ymguo-phy/Lab_IV_Spectrometer/Lecture_Note/Spectrometer casing.png

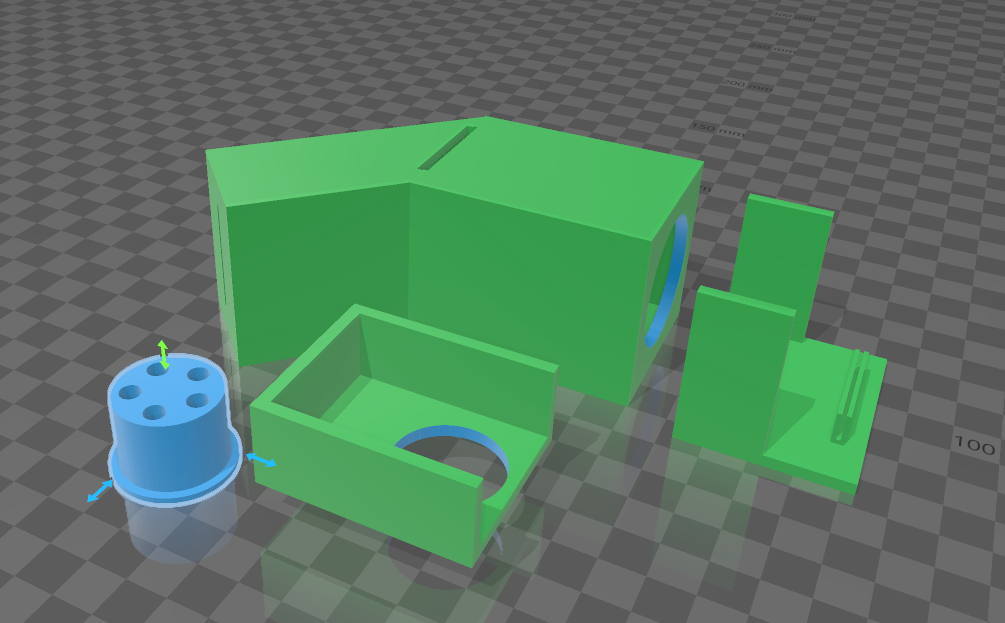
Lecture_Note/Spectrometer casing.png
