ymguo-phy/Lab_IV_Spectrometer/origin_data/Exp6/1/0_11Exp_1.jpg

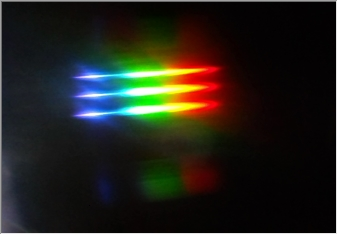
origin_data/Exp6/1/0_11Exp_1.jpg
