ymguo-phy/Lab_IV_Spectrometer/README.md

# Lab_IV_Spectrometer
This repo is built for storage the project of DIY Spectrometer.
