ymguo-phy/Lab_IV_Spectrometer/Proposal/procedure_of_LED.md

1. 校准电压表
2. 用红色激光和绿色激光校准spectrometer
3. 将指定的若干相同颜色的LED灯珠串联安装在面包板上，将面包板固定在testing module上。通过导线接通电源，确保电路连接没有问题，LED正常亮起
4. 将module连接spectrometer，接通电源，待软件显示产生稳定的光强度光谱之后，记录实验光谱。
5. 同时记录LED灯串两端的电压并记录。
6. 关闭电源，重新打开，进行重复实验，重复以上操作，记录大于3组的数据以减少误差。
7. 更换LED灯珠，使用不同颜色的LED灯，重复以上操作。
