ymguo-phy/Lab_IV_Spectrometer/Proposal/some_chart.xlsx

Sheet: Sheet1
Wavelength/ | 500nm | 650nm
Intensity
Concentration
Deionized water
0.1mol/L Solution
0.5 mol/L Solution
1 mol/L Solution
2 mol/L Solution

Sheet: Sheet2
Experiment data of Planck Constant measurement for LED light source with zero point method
Forward Voltage(V) | 0.988 | 0.691 | 0.445 | 0.382 | 0.311
Central wavelength(nm) | 629.6 | 604.1 | 593.1 | 523.4 | 462.7
Approximated wavelength(nm) | 629.6 | 608.1 | 590.1 | 529.4 | 470.8

Sheet: Sheet3
Wavelength(nm) | Grating | 5 | 10 | 15
532 | CD
 | DVD
650 | CD
 | DVD
 | Spots too close
 | Spots out of range
 | Able to conduct the experiment

Sheet: Sheet4
Camparative data of planck constant measurement experiment for LED source with zero point method
Approximated wavelength(nm) | 470.8 | 529.4 | 590.1 | 608.1 | 629.6 | the value of h | relative error(%)
1 | 1.004 | 0.72 | 0.5 | 0.448 | 0.37 | 6.0947 | 5.6
2 | 0.921 | 0.647 | 0.409 | 0.341 | 0.28 | 6.4376 | 2.9
3 | 0.943 | 0.686 | 0.466 | 0.427 | 0.299 | 6.1556 | 7.1
4 | 0.891 | 0.659 | 0.389 | 0.357 | 0.297 | 6.0723 | 8.2
