ymguo-phy/Lab_IV_Spectrometer/Proposal/exp2.md

在实验中我们使用了5种不同颜色LED灯进行试验，我们使用12V的电压提供电压，并使用不同的电阻对实验中的电流大小进行调整，以使得LED灯能够处于刚好被激发的正向电压状态，在实验中，我们将万能表调节至直流电20V的状态之下，同时将两个表笔固定的插在面包半中，用于测量并联的电压的大小
