ymguo-phy/Lab_IV_Spectrometer/Plan/20.4.2022.md

## Planck Constant

1. Design the circuit diagram

2. Essential equation

## Absorption

1. Determine the concentration resolution
2. Design model
3. Set the hypothesis and the method of experiement
4. 

## Presentation

1. Experiment Goal
2. Experiment Hypothesis
3. Distribution of Work
4. Experiment Method
5. Graph of Essential Parts
6. 实验的具体参数
7. Data analysis method
8. Some milestone progress
9. Budget

## Measure the diffraction Grating Constant (Plan)

(GUO YIMING)

1. Design the model of experiment
2. Improve the method
3.
