ymguo-phy/Lab_IV_Spectrometer/Final Report/2.jpg

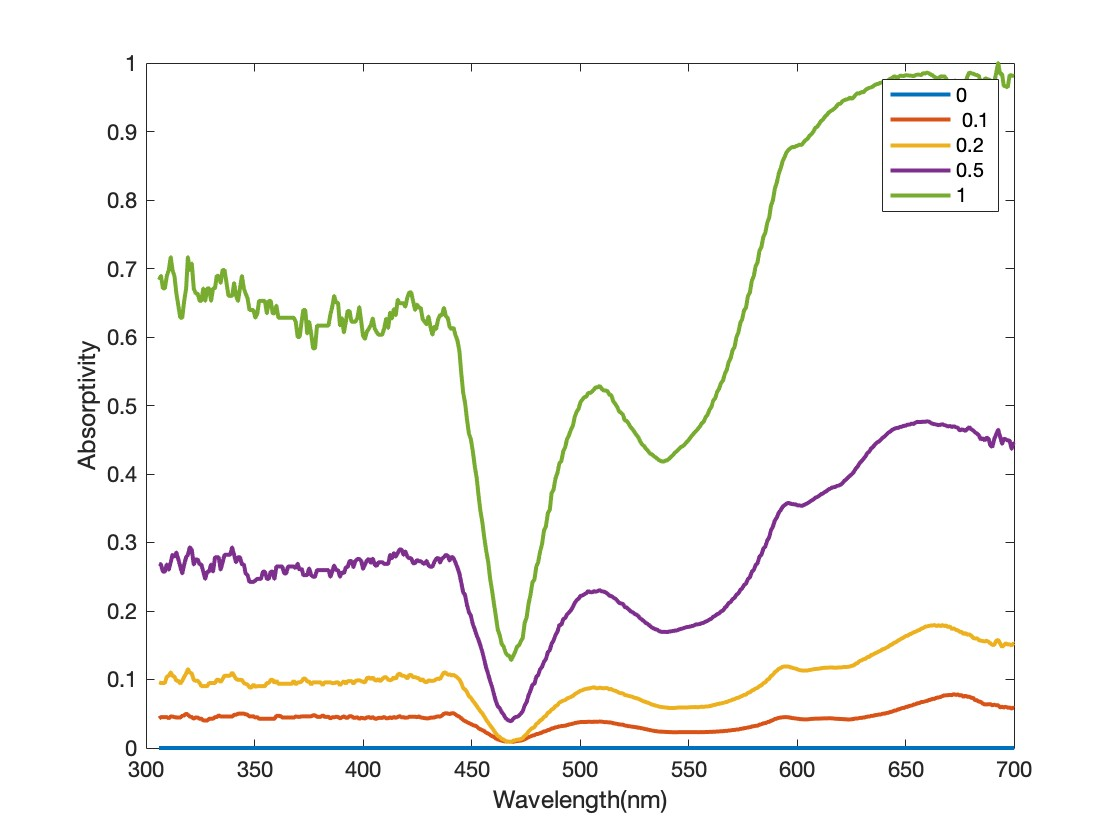
Final Report/2.jpg
