ymguo-phy/Lab_IV_Spectrometer/Final Report/modify.jpg

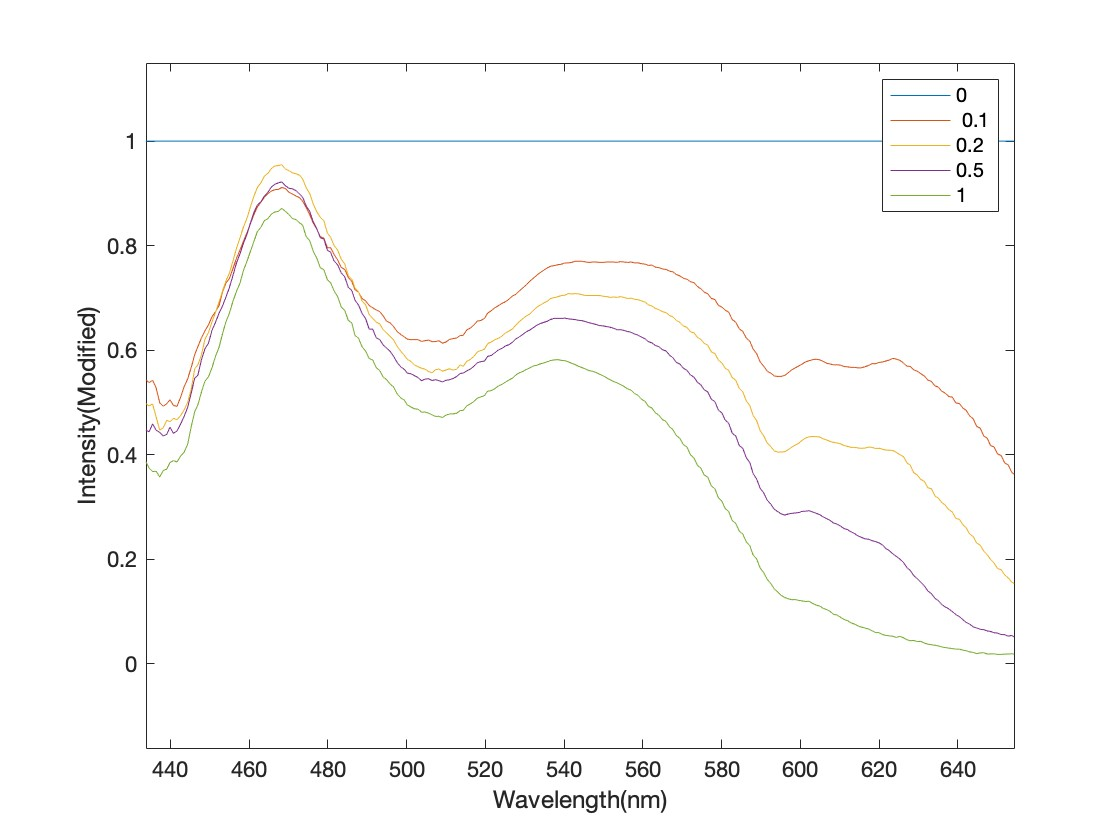
Final Report/modify.jpg
