ymguo-phy/Lab_IV_Spectrometer/Final Report/Origin_data.jpg

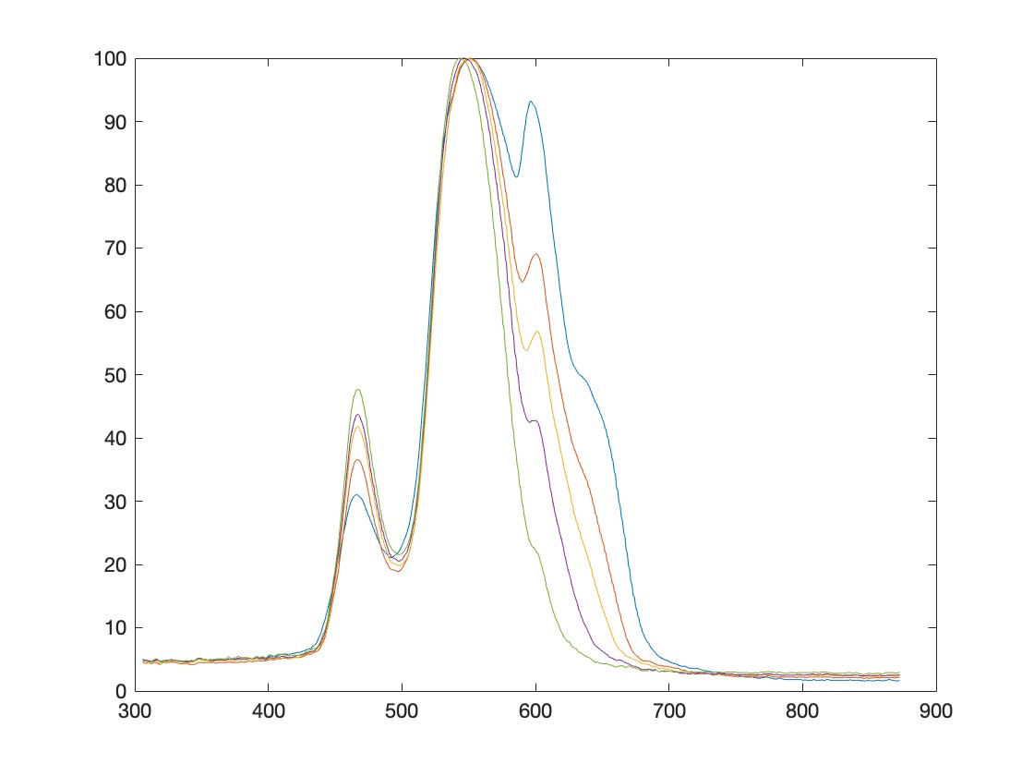
Final Report/Origin_data.jpg
