ymguo-phy/Lab_IV_Spectrometer/origin_data/Exp6/1_1/0_24.jpg

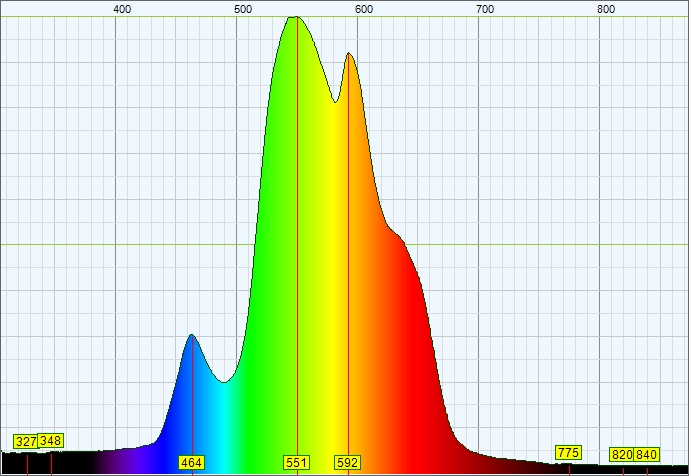
origin_data/Exp6/1_1/0_24.jpg
