ymguo-phy/Lab_IV_Spectrometer/origin_data/Exp6/1_1/0_26.jpg

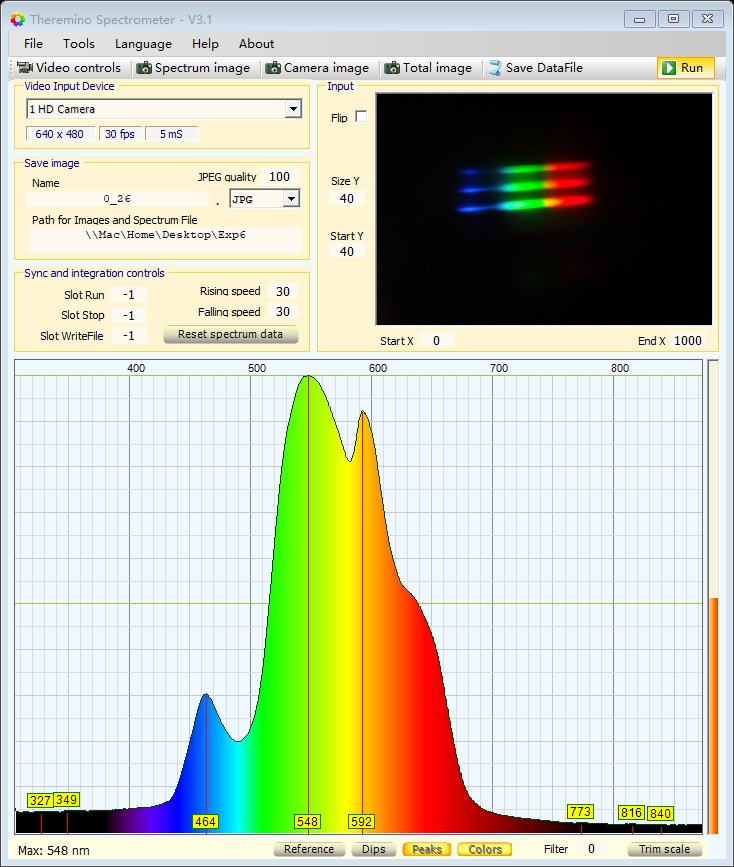
origin_data/Exp6/1_1/0_26.jpg
