ymguo-phy/Lab_IV_Spectrometer/origin_data/Exp6/2/0_12Exp_2.jpg

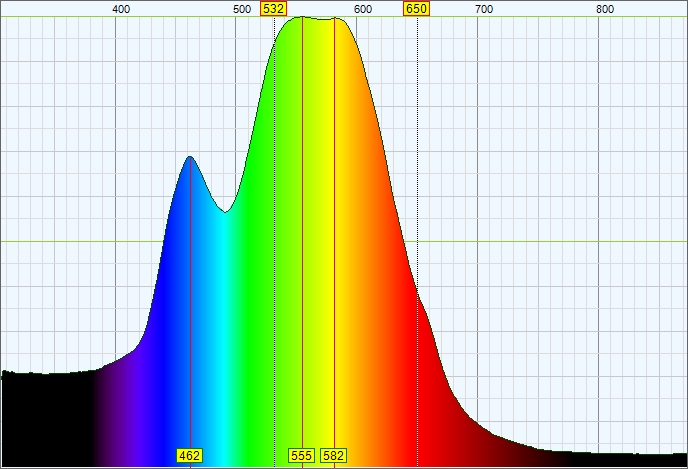
origin_data/Exp6/2/0_12Exp_2.jpg
