ymguo-phy/Lab_IV_Spectrometer/origin_data/Exp6/4/0_20Exp_4.jpg

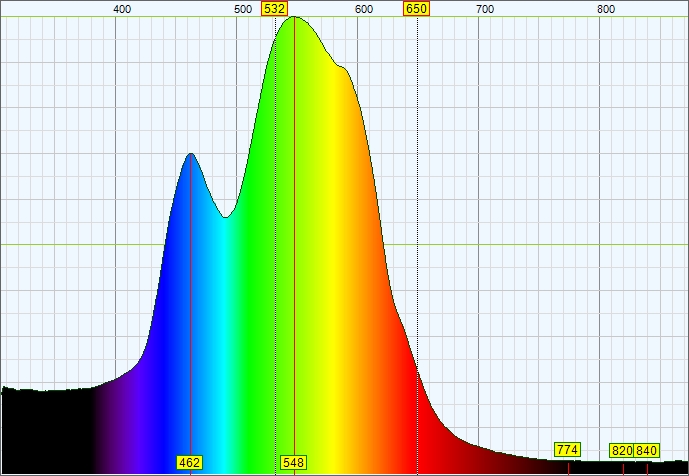
origin_data/Exp6/4/0_20Exp_4.jpg
