ymguo-phy/Lab_IV_Spectrometer/origin_data/Exp6/5/0_22Exp_5.jpg

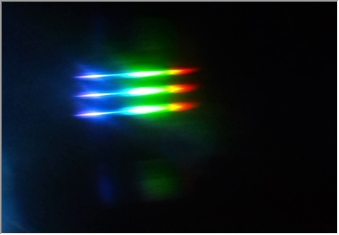
origin_data/Exp6/5/0_22Exp_5.jpg
