ymguo-phy/Lab_IV_Spectrometer/origin_data/Exp6/5/0_23Exp_5.jpg

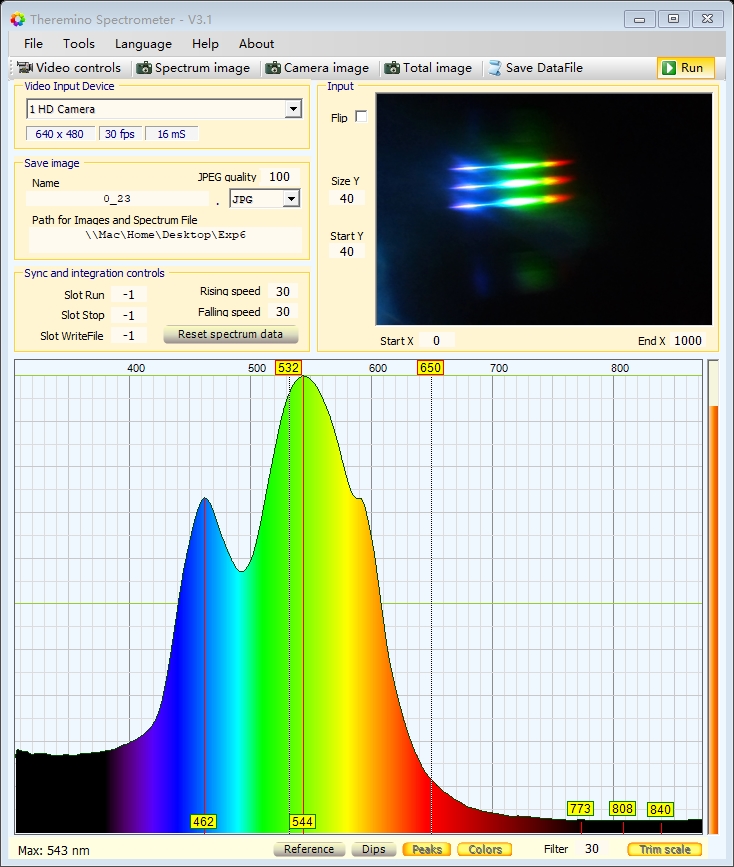
origin_data/Exp6/5/0_23Exp_5.jpg
