ymguo-phy/Lab_IV_Spectrometer/origin_data/Exp7/2/0_30.jpg

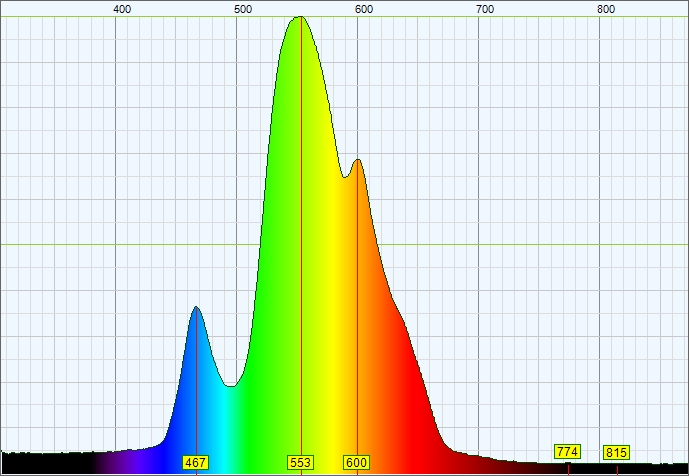
origin_data/Exp7/2/0_30.jpg
