ymguo-phy/Lab_IV_Spectrometer/origin_data/Exp7/2/0_31.jpg

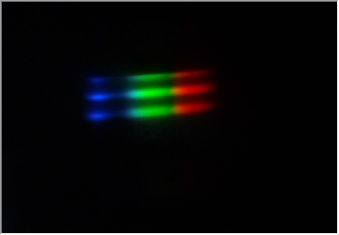
origin_data/Exp7/2/0_31.jpg
