ymguo-phy/Lab_IV_Spectrometer/origin_data/Exp7/3/0_33.jpg

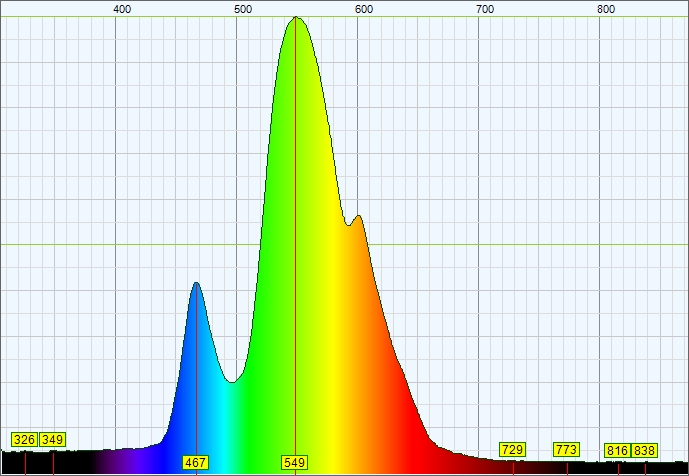
origin_data/Exp7/3/0_33.jpg
