ymguo-phy/Lab_IV_Spectrometer/origin_data/Exp7/4/0_38.jpg

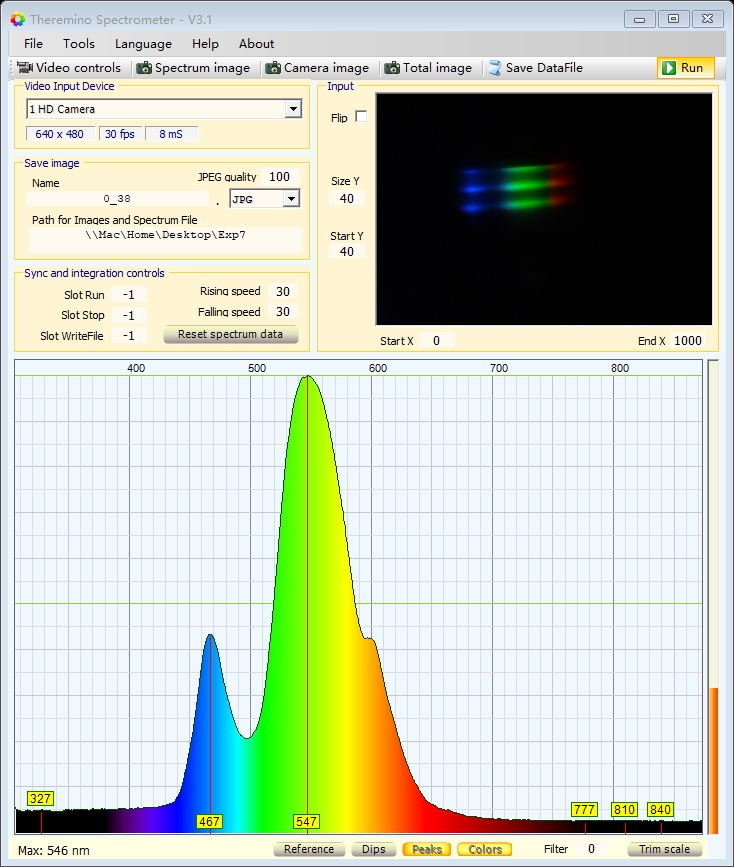
origin_data/Exp7/4/0_38.jpg
