ymguo-phy/Lab_IV_Spectrometer/origin_data/Exp7/5/0_40.jpg

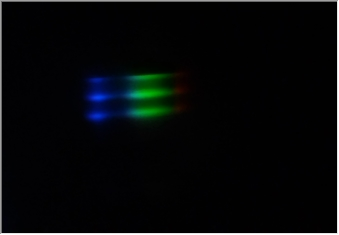
origin_data/Exp7/5/0_40.jpg
