ymguo-phy/Lab_IV_Spectrometer/Plan/budget/IMG_9627.PNG

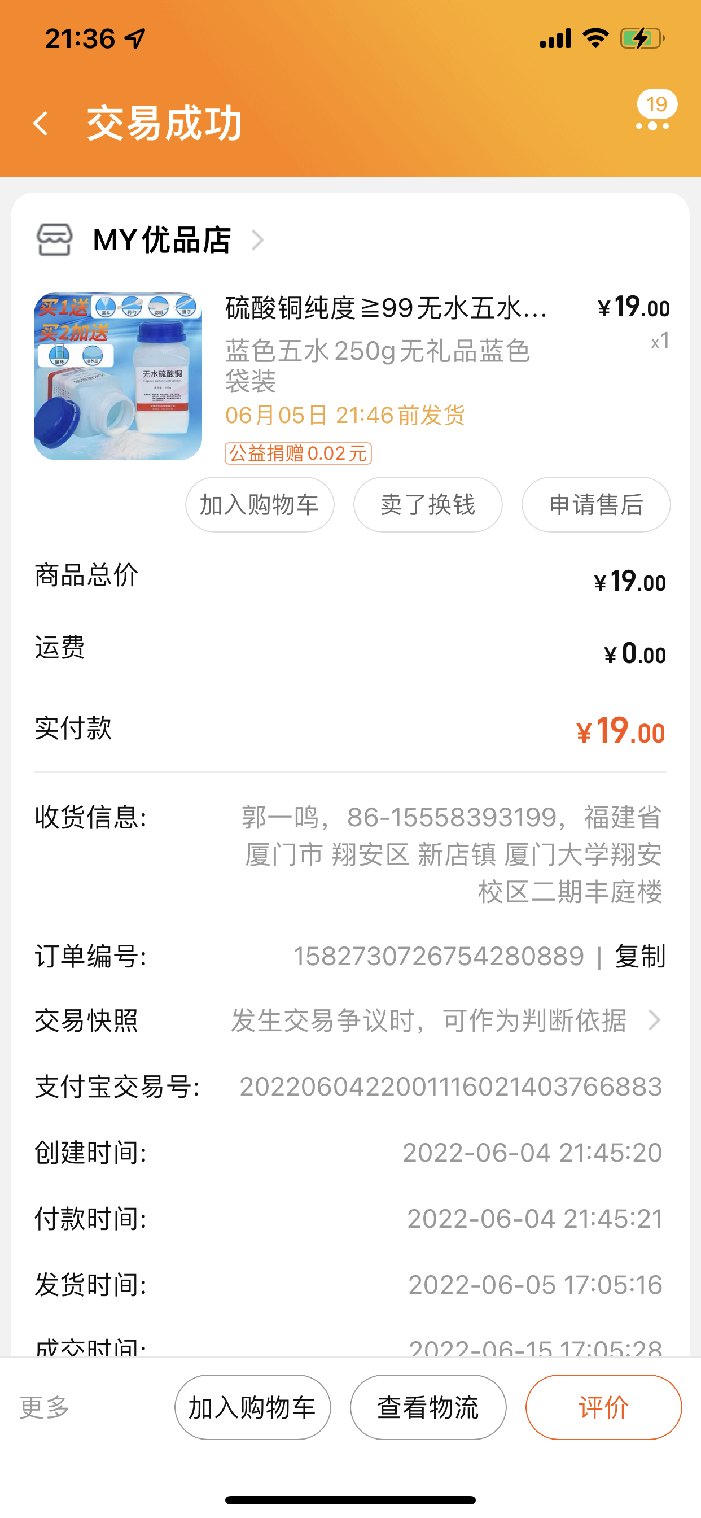
Plan/budget/IMG_9627.PNG
