ymguo-phy/Lab_IV_Spectrometer/Plan/budget/IMG_9628.PNG

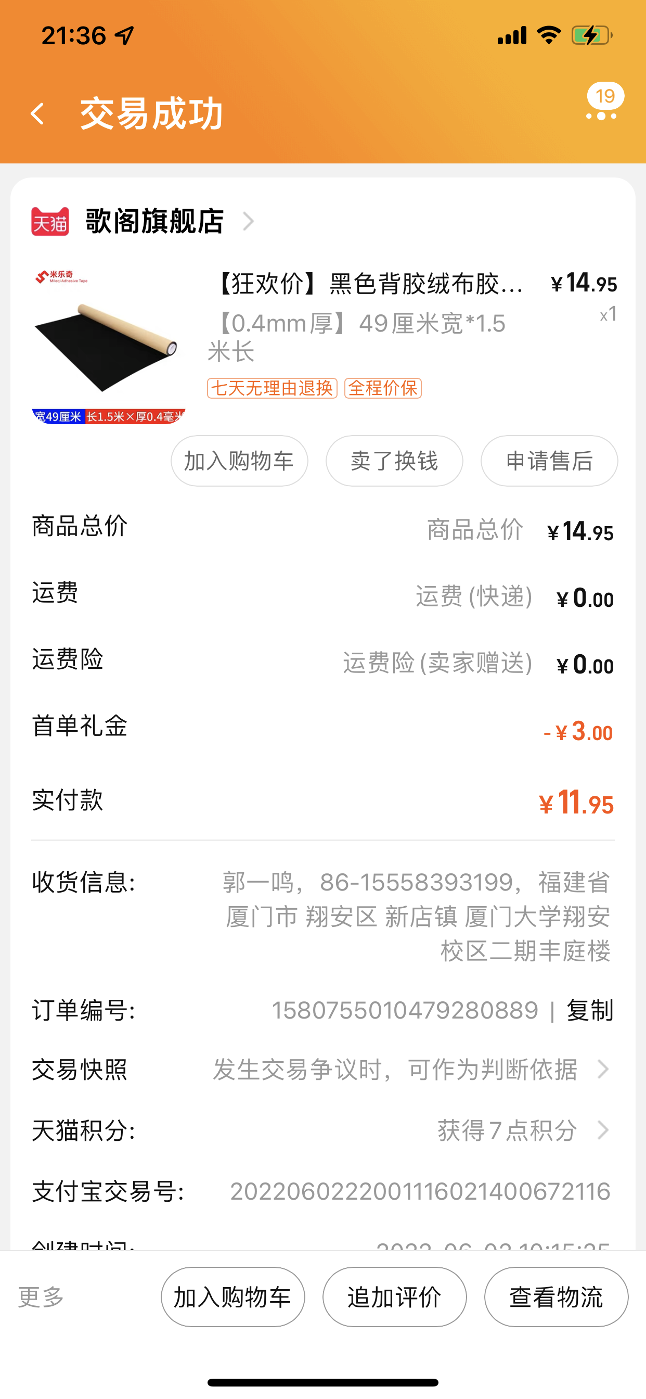
Plan/budget/IMG_9628.PNG
