ymguo-phy/Lab_IV_Spectrometer/Plan/budget/IMG_9629.PNG

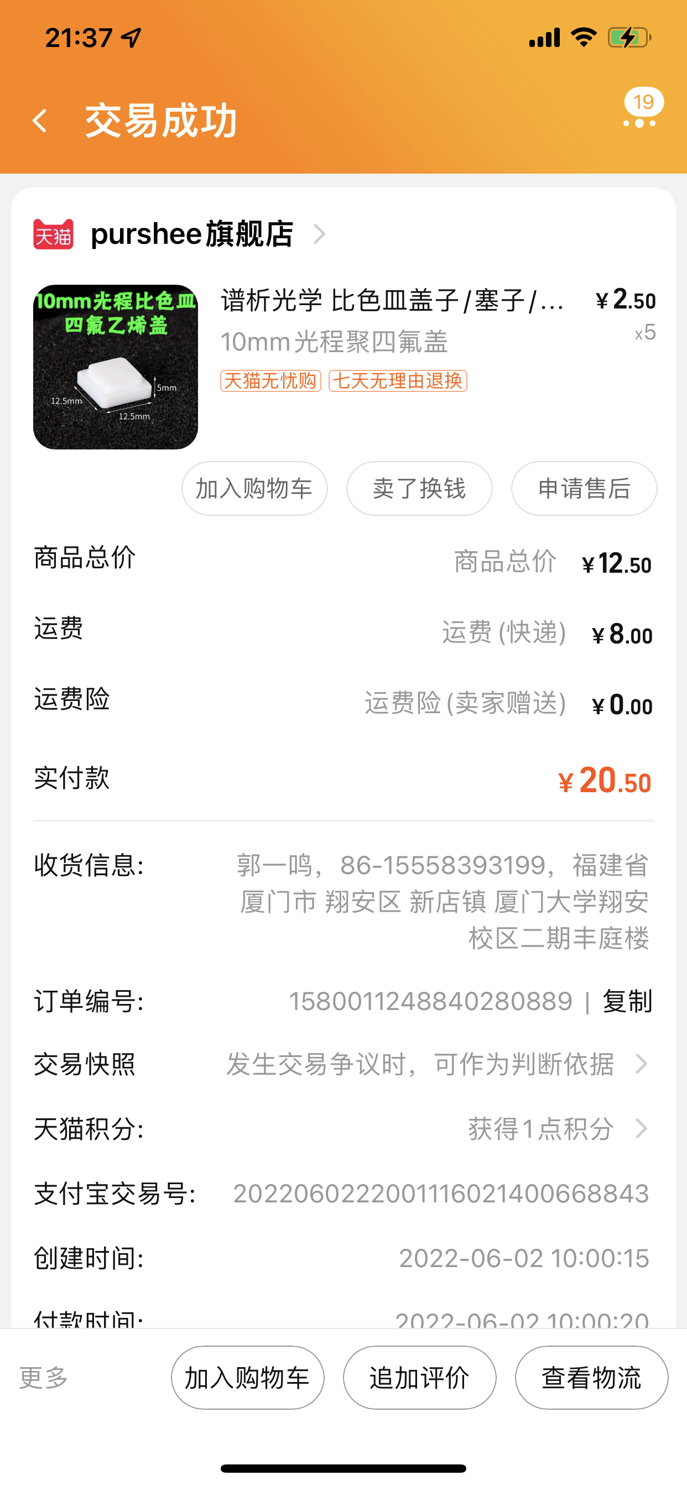
Plan/budget/IMG_9629.PNG
