ymguo-phy/Lab_IV_Spectrometer/Plan/budget/IMG_9631.PNG

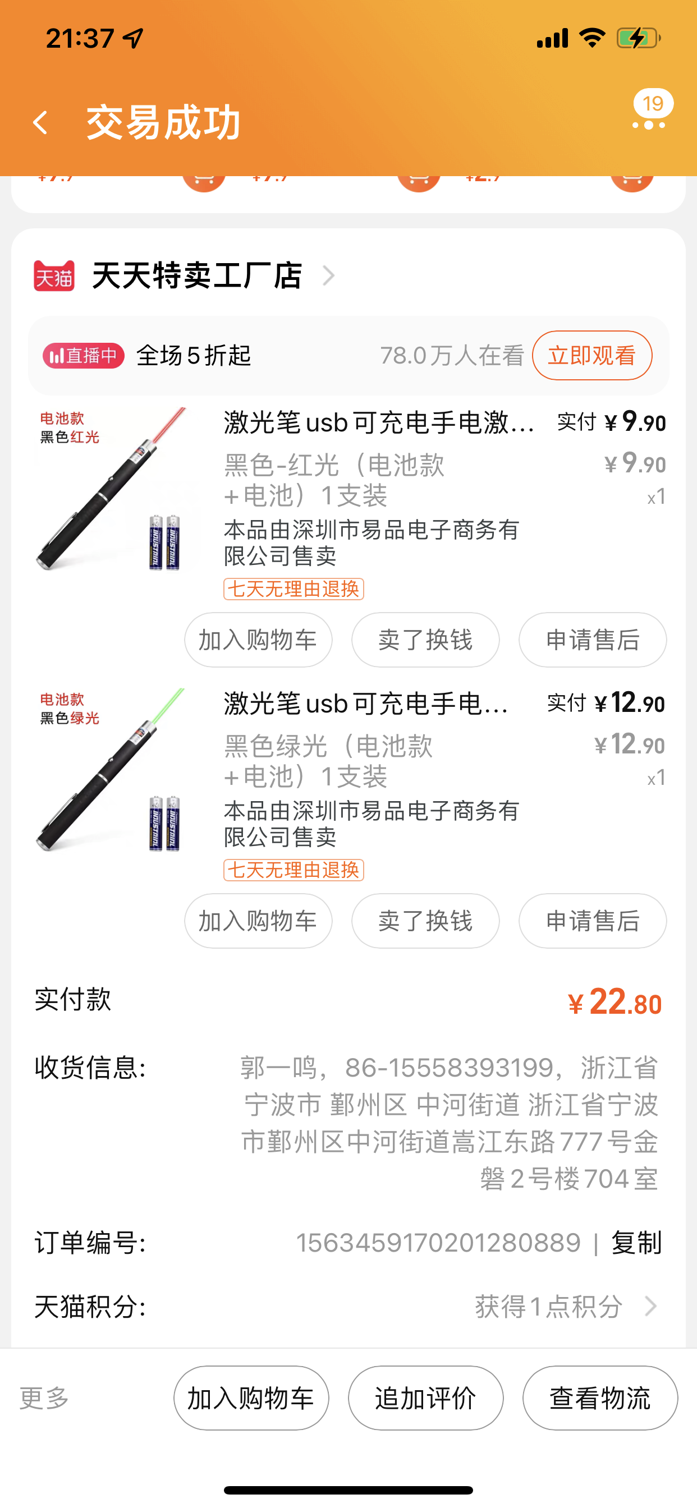
Plan/budget/IMG_9631.PNG
