ymguo-phy/Lab_IV_Spectrometer/Plan/budget/IMG_9632.PNG

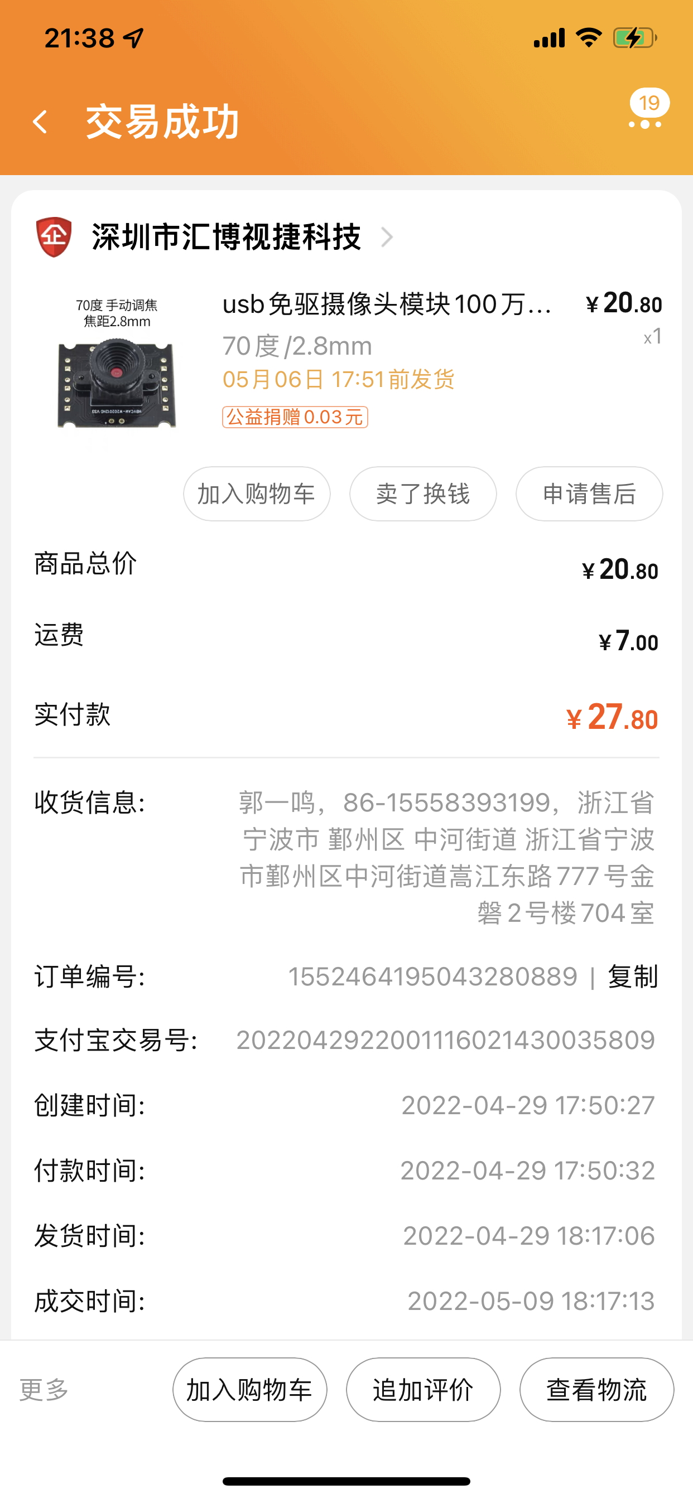
Plan/budget/IMG_9632.PNG
