ymguo-phy/Lab_IV_Spectrometer/Plan/budget/IMG_9633.PNG

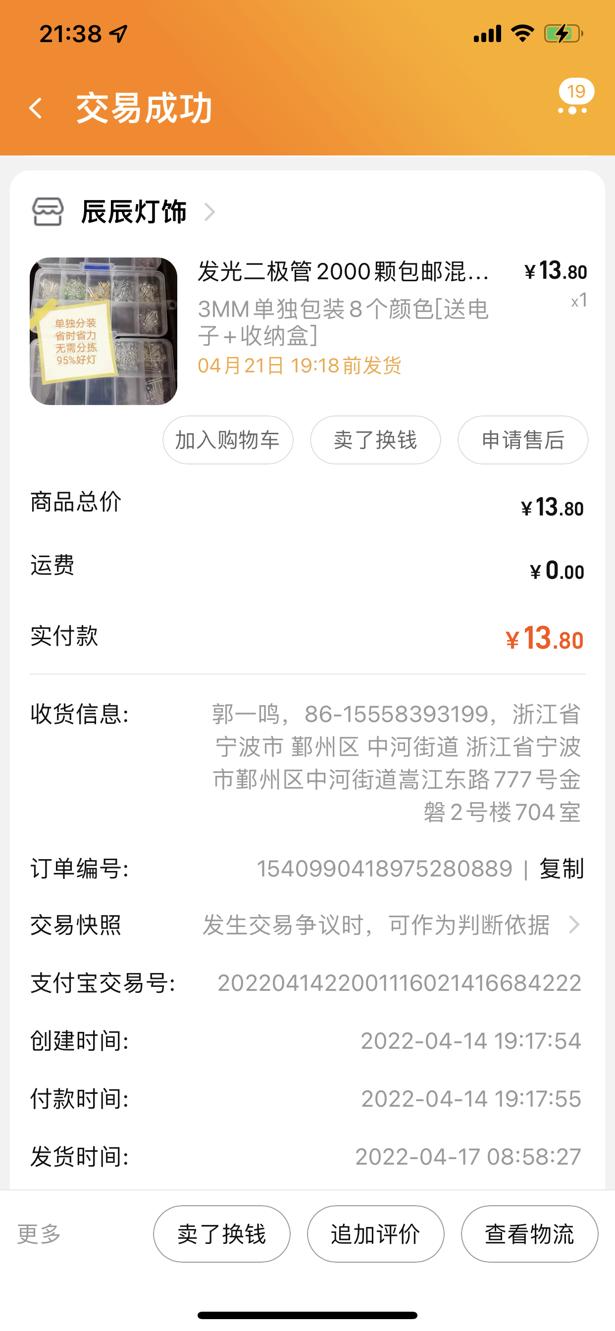
Plan/budget/IMG_9633.PNG
