ymguo-phy/Lab_IV_Spectrometer/Plan/budget/IMG_9635.PNG

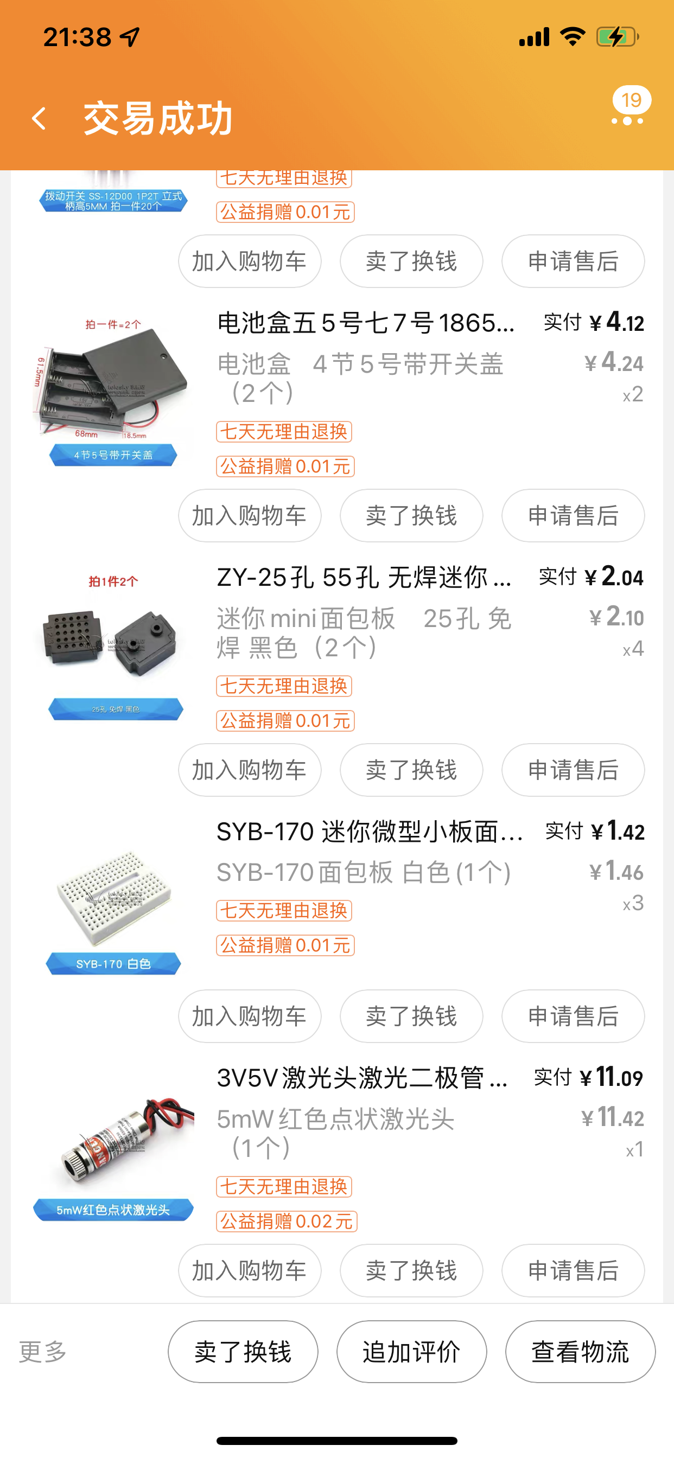
Plan/budget/IMG_9635.PNG
