ymguo-phy/Lab_IV_Spectrometer/Plan/budget/IMG_9636.PNG

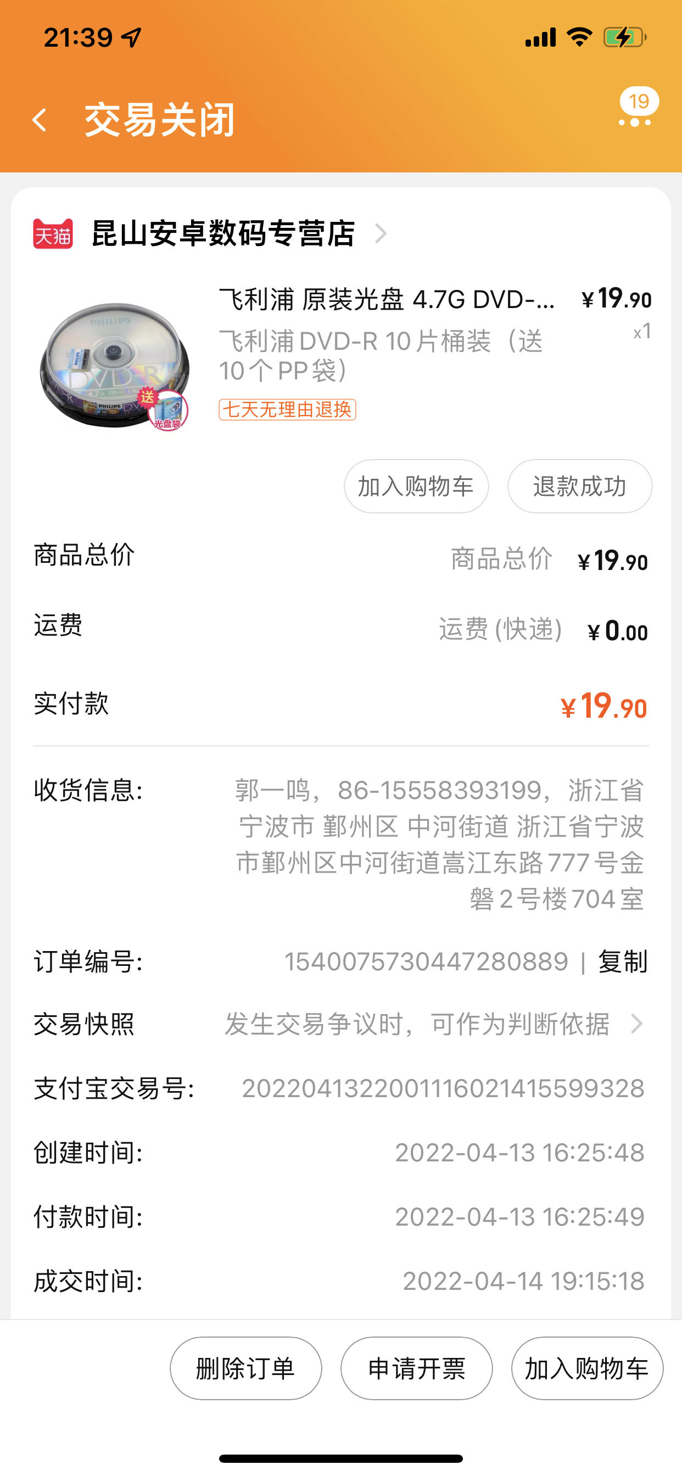
Plan/budget/IMG_9636.PNG
