ymguo-phy/Lab_IV_Spectrometer/Plan/Budget.xlsx

Budget List of Lab Project 2022/04(Group 4)
Author | Guo Yiming | Update Date | 1/7/2022
Member | Guo Yiming, Yang Ziou, Wang Yiran
exchange rate(RM-CNY) | 1.5 | Update Date | 7/1/2022
No | Item | Quanta | CNY Price | RM Price | Total (RM) | reimbursement(1/0) | Purchase Link | Shop Link | Memo
 | Part 1: Experiment on Diffraction Grating
1 | CD | 2 | 0.00 | 0.00 | 0.00 | 1
2 | DVD | 5 | 2.68 | 1.79 | 8.93 | 1
3 | laser emitter | 2 | 11.42 | 7.61 | 15.23 | 1
 |  |  |  |  | 0.00
 | Part 2: Make a Spectrometer |  |  |  | 0.00
4 | 3D Model Printing Fee | 1 | 200.00 | 133.33 | 133.33 | 1
5 | magnet | 19 | 1.00 | 0.67 | 12.67 | 1
6 | blackout carpet | 1 | 22.00 | 14.67 | 14.67 | 1
7 | Camera Module | 1 | 20.80 | 13.87 | 13.87 | 1
 |  |  |  |  | 0.00
 | Part 3: Application 1:Planck Constant |  |  |  | 0.00
8 | LED light group(8 color) | 1 | 13.80 | 9.20 | 9.20 | 1
9 | DuPont line | 1 | 0.00 | 0.00 | 0.00 | 0
10 | Bread board | 1 | 0.00 | 0.00 | 0.00 | 0
11 | Battery box | 2 | 0.00 | 0.00 | 0.00 | 0
12 | Universal electric meter | 1 | 0.00 | 0.00 | 0.00 | 0
13 | resistance | 1 | 0.00 | 0.00 | 0.00 | 0
14 | switch | 1 | 0.00 | 0.00 | 0.00 | 0
 |  |  |  |  | 0.00
 | Part 4: Absorption spectrum of solution
14.00 | cuvette cover | 5.00 | 4.10 | 2.73 | 13.67 | 1.00
15.00 | Cuvette(10mm) | 10.00 | 2.90 | 1.93 | 19.33 | 1.00
16.00 | LED Light board | 2.00 | 7.61 | 5.07 | 10.15 | 1.00
 |  |  |  |  | 0.00
 | Others |  |  |  | 0.00
17 | Equipment damage(Unexpected expenditure) | 1 | 50.00 | 33.33 | 0.00 | 1
18 | Logistics price | 1 | 20.00 | 13.33 | 0.00 | 1
 | Total |  |  |  | 251.04
