ymguo-phy/Lab_IV_Spectrometer/Lecture_Note/Essential parts.docx

Some essential parts you may need in your project

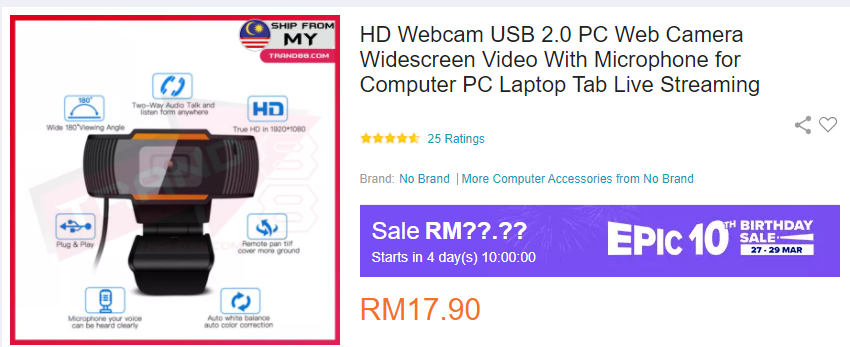
[picture p226: figure]

| RM 17.9

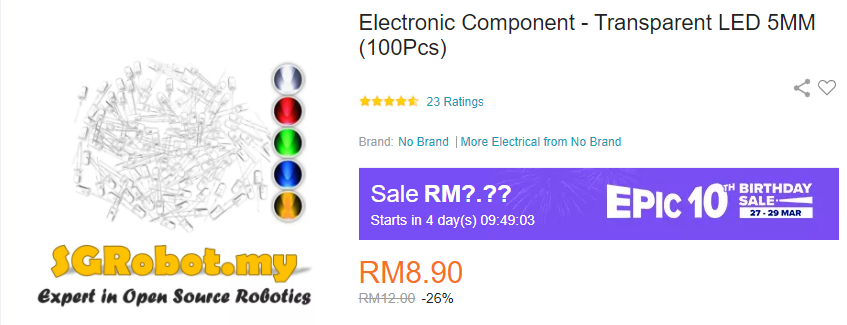
[picture p227: figure]

| RM 8.90

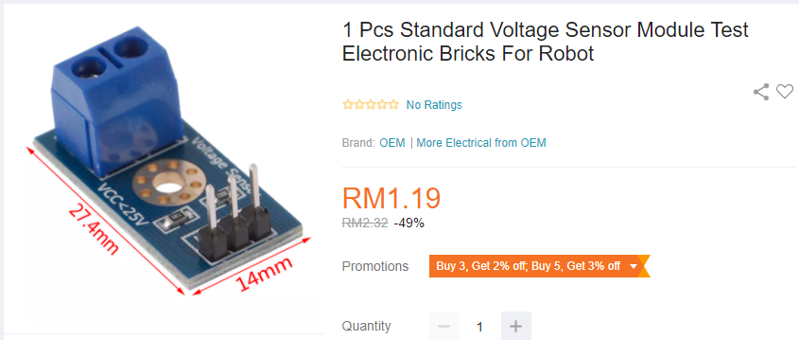
[picture p228: figure]

| RM 1.20

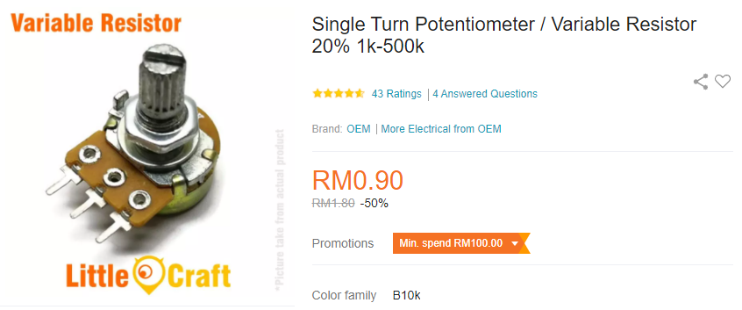
[picture p229: figure]

| RM 0.90

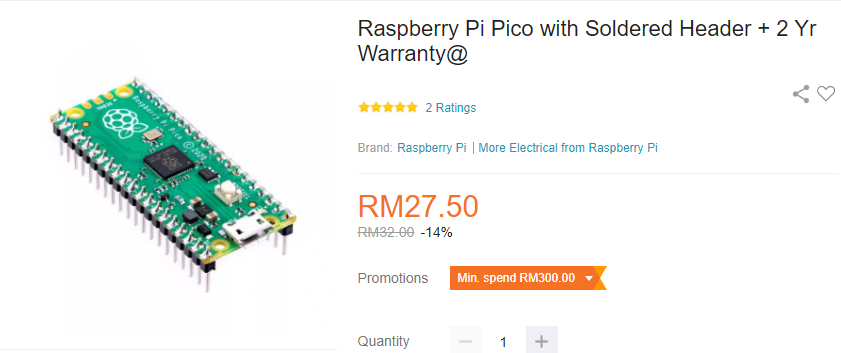
[picture p230: figure]

| RM 27.50
Total | RM 56.4

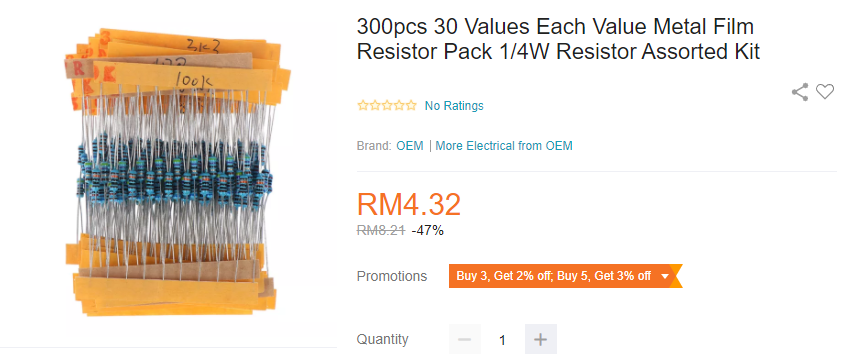
[picture p231: figure]
