ymguo-phy/Lab_IV_Spectrometer/3Dmodel/Spectrometer2.0/3D_printable_file/1/Spectrometer_Cover.stl

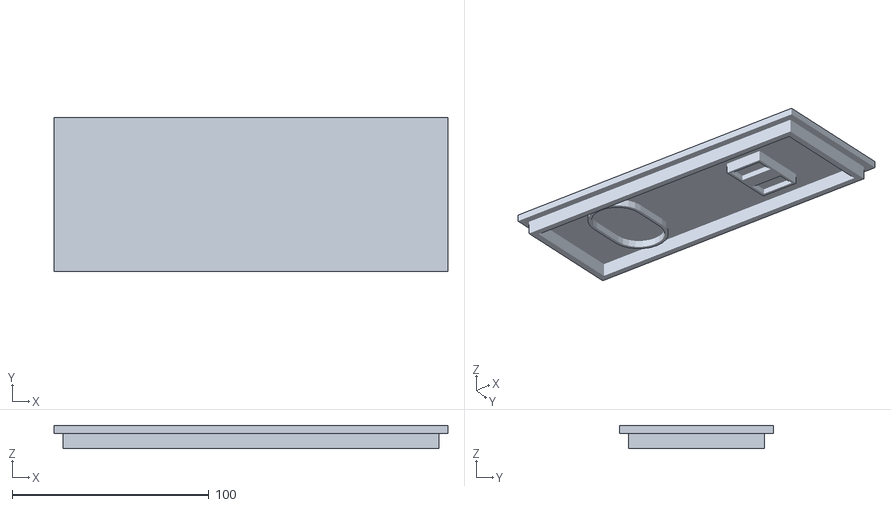
[picture p232: CAD file, 2022-04-26]
3Dmodel/Spectrometer2.0/3D_printable_file/1/Spectrometer_Cover.stl
200.0 x 78.0 x 11.8
