ymguo-phy/Lab_IV_Spectrometer/3Dmodel/Spectrometer2.0/3D_printable_file/2.1/2.3_B_2.stl

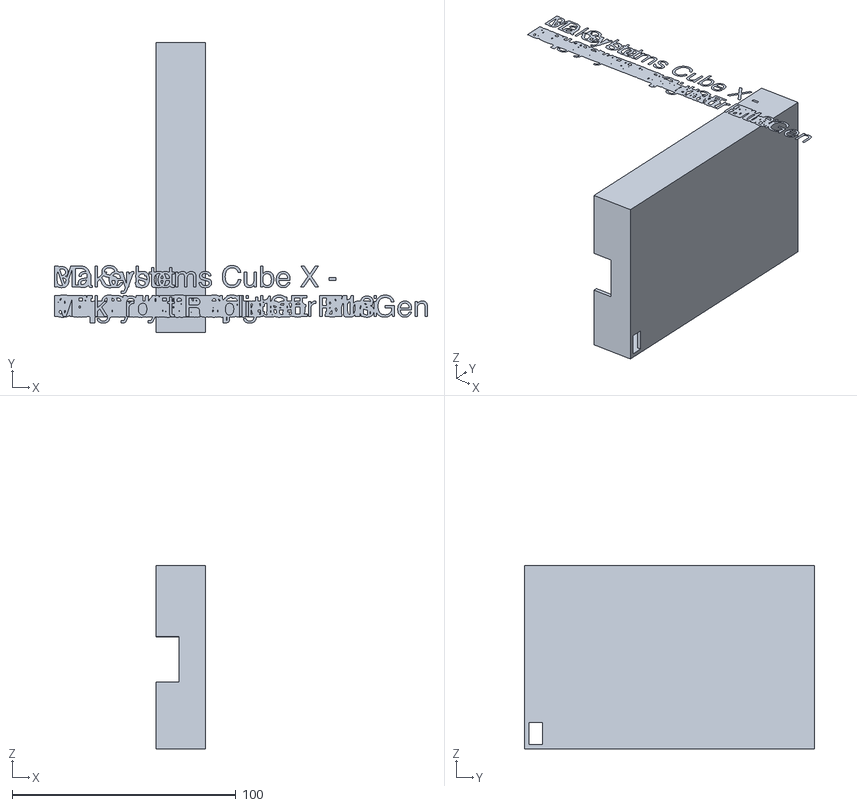
[picture p233: CAD file, 2022-06-27]
3Dmodel/Spectrometer2.0/3D_printable_file/2.1/2.3_B_2.stl
166.8 x 129.5 x 151.1
