ymguo-phy/Lab_IV_Spectrometer/3Dmodel/Spectrometer2.0/3D_printable_file/2Batch/2.3_B.stl

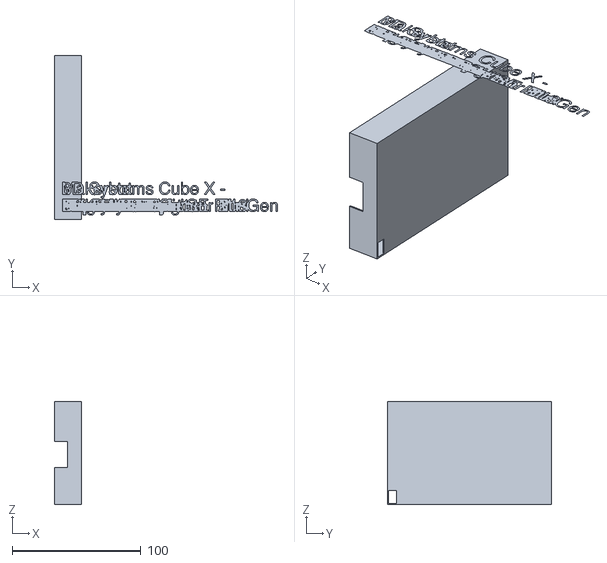
[picture p234: CAD file, 2022-06-27]
3Dmodel/Spectrometer2.0/3D_printable_file/2Batch/2.3_B.stl
173.2 x 127.5 x 150.1
