ymguo-phy/Lab_IV_Spectrometer/Lecture_Note/spectrometer.3mf

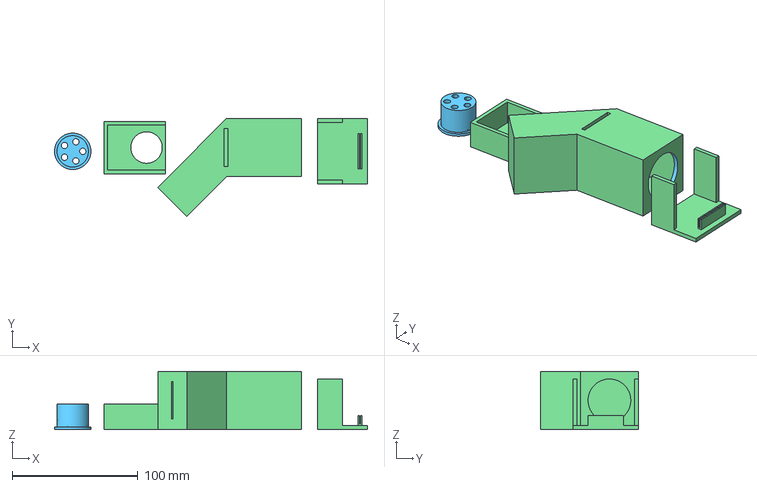
[picture p235: CAD file, 2022-04-26]
Lecture_Note/spectrometer.3mf
249.0 x 77.7 x 46.2 mm
