ymguo-phy/Lab_IV_Spectrometer/3Dmodel/Spectrometer2.0/3D_printable_file/1/Spectrometer_Body.stl

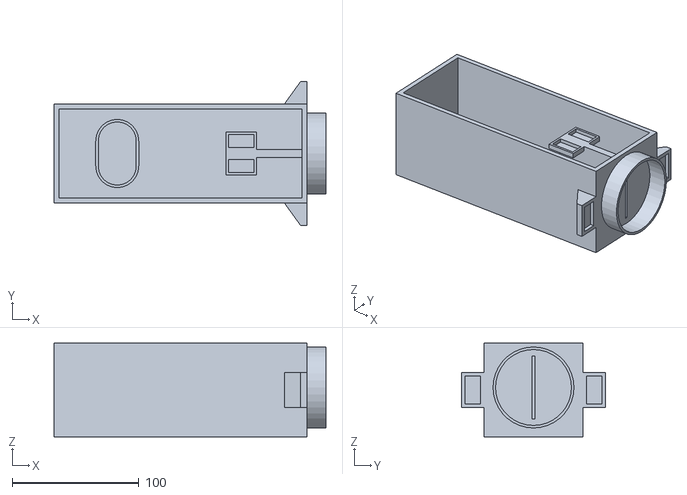
[picture p236: CAD file, 2022-04-26]
3Dmodel/Spectrometer2.0/3D_printable_file/1/Spectrometer_Body.stl
215.0 x 114.0 x 74.0
