ymguo-phy/Lab_IV_Spectrometer/3Dmodel/Spectrometer2.0/3D_printable_file/2.1/3.1_B_2.stl

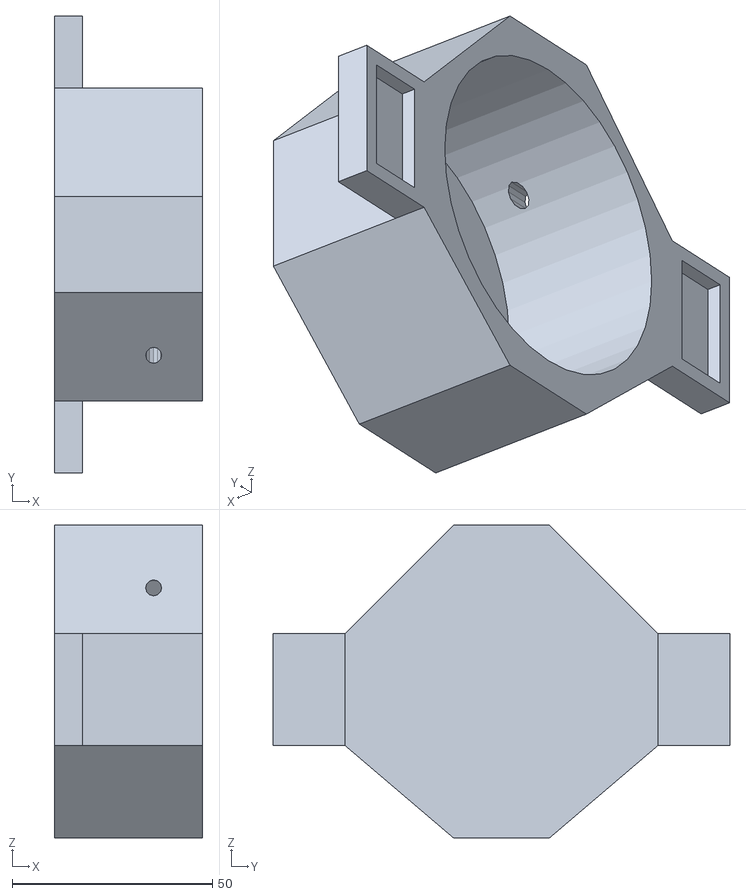
[picture p237: CAD file, 2022-06-27]
3Dmodel/Spectrometer2.0/3D_printable_file/2.1/3.1_B_2.stl
37.0 x 114.0 x 78.0
