ymguo-phy/Lab_IV_Spectrometer/3Dmodel/Spectrometer2.0/3D_printable_file/2Batch/2.1_B.stl

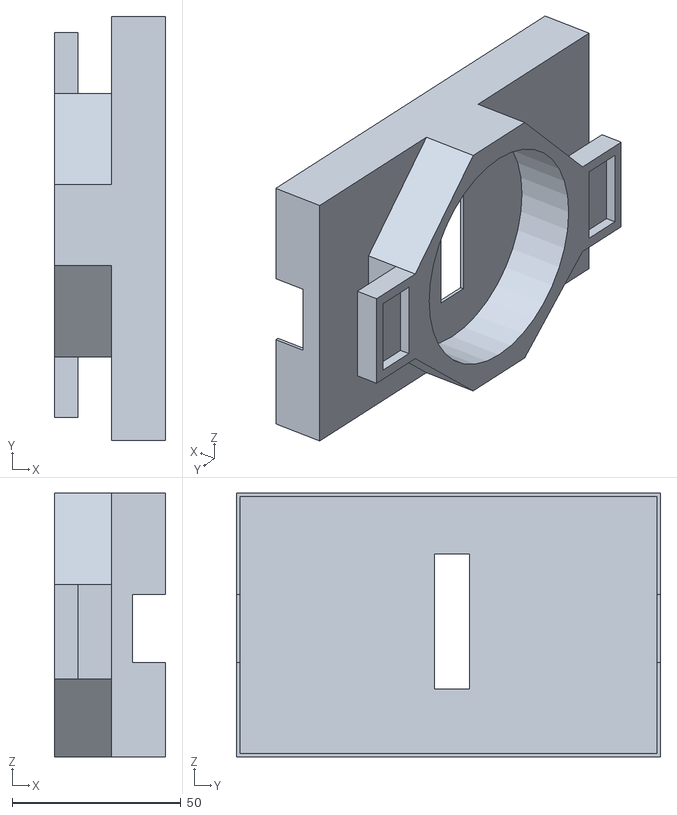
[picture p238: CAD file, 2022-06-27]
3Dmodel/Spectrometer2.0/3D_printable_file/2Batch/2.1_B.stl
33.0 x 125.5 x 78.0
