ymguo-phy/Lab_IV_Spectrometer/3Dmodel/Spectrometer2.0/3D_printable_file/1/Camera_Dock.stl

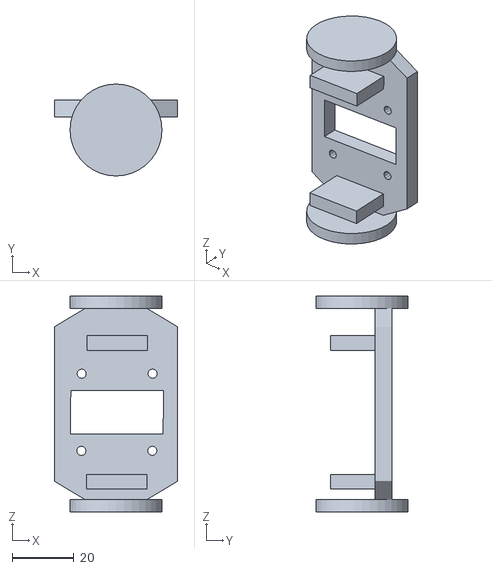
[picture p239: CAD file, 2022-04-26]
3Dmodel/Spectrometer2.0/3D_printable_file/1/Camera_Dock.stl
40.0 x 29.8 x 70.0
