ymguo-phy/Lab_IV_Spectrometer/3Dmodel/Spectrometer2.0/3D_printable_file/2.1/1.0_底座三脚架连接_A_2.stl

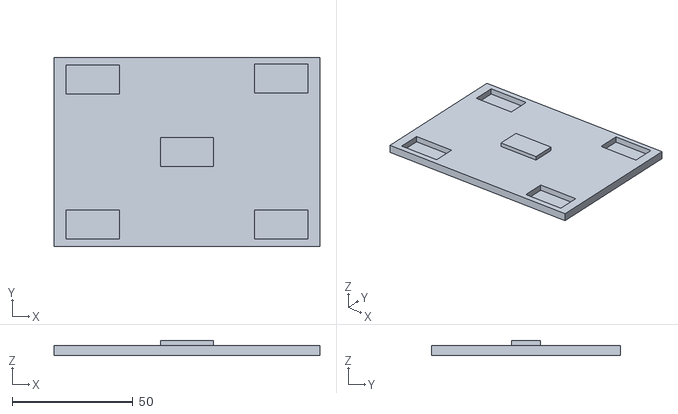
[picture p240: CAD file, 2022-06-27]
3Dmodel/Spectrometer2.0/3D_printable_file/2.1/1.0_底座三脚架连接_A_2.stl
110.0 x 78.0 x 6.00
