ymguo-phy/Lab_IV_Spectrometer/3Dmodel/Spectrometer2.0/3D_printable_file/1/Disc_Dock.stl

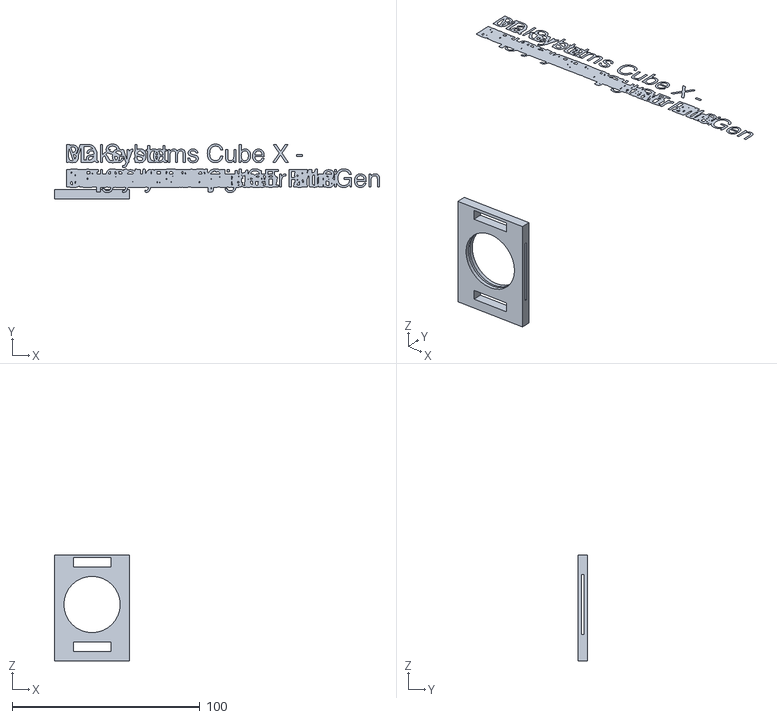
[picture p241: CAD file, 2022-04-26]
3Dmodel/Spectrometer2.0/3D_printable_file/1/Disc_Dock.stl
173.2 x 29.3 x 150.1
