ymguo-phy/Lab_IV_Spectrometer/3Dmodel/Spectrometer2.0/3D_printable_file/2.1/2.2_B_2.stl

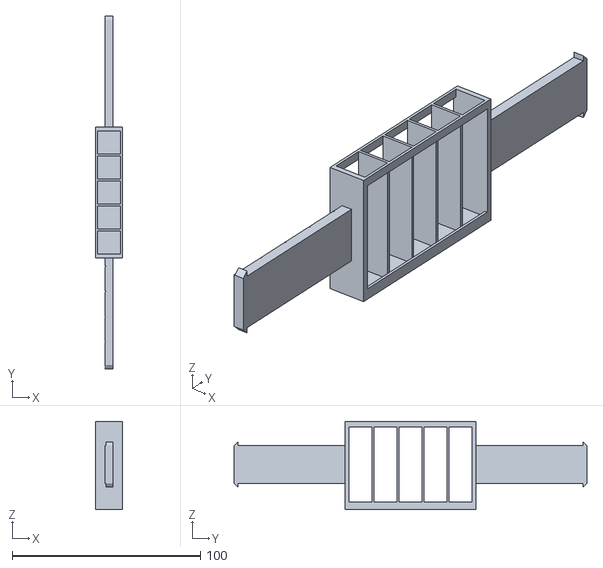
[picture p242: CAD file, 2022-06-27]
3Dmodel/Spectrometer2.0/3D_printable_file/2.1/2.2_B_2.stl
14.3 x 187.5 x 47.0
