ymguo-phy/Lab_IV_Spectrometer/3Dmodel/Spectrometer2.0/3D_printable_file/2Batch/3.1_B.stl

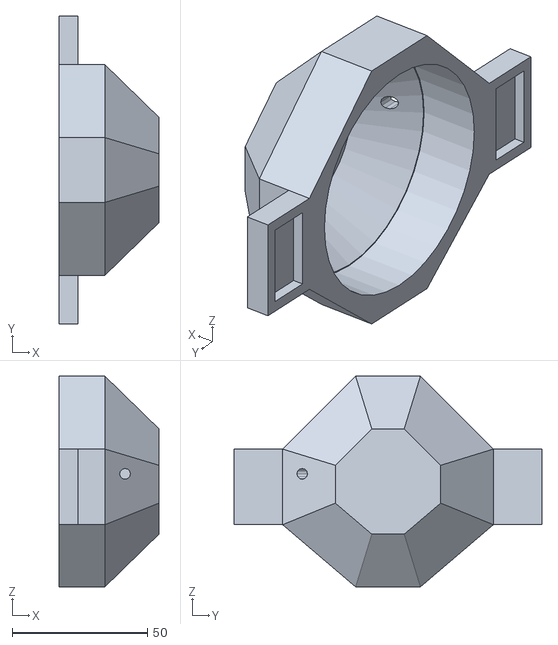
[picture p243: CAD file, 2022-06-27]
3Dmodel/Spectrometer2.0/3D_printable_file/2Batch/3.1_B.stl
37.0 x 114.0 x 78.0
