ymguo-phy/Lab_IV_Spectrometer/3Dmodel/Spectrometer2.0/3D_printable_file/2Batch/2.2_B.stl

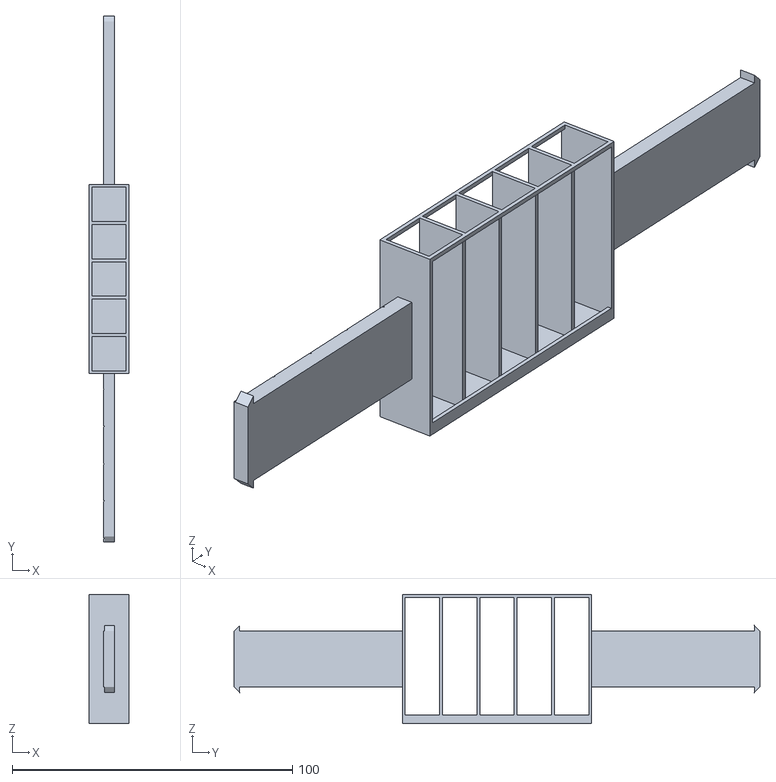
[picture p244: CAD file, 2022-06-27]
3Dmodel/Spectrometer2.0/3D_printable_file/2Batch/2.2_B.stl
14.3 x 187.5 x 46.0
