ymguo-phy/Lab_IV_Spectrometer/(list of files, cad)

Other CAD files:
3Dmodel/Spectrometer2.0/3D_printable_file/2.1/2.1_B_2.stl
3Dmodel/Spectrometer2.0/SketchUp_source_file/Spectrometer/Camera_Dock.skp
3Dmodel/Spectrometer2.0/SketchUp_source_file/Spectrometer/Disc_Dock.skp
3Dmodel/Spectrometer2.0/SketchUp_source_file/Spectrometer/Spectrometer.skp
3Dmodel/Spectrometer2.0/SketchUp_source_file/Spectrometer/Spectrometer_Body.skp
3Dmodel/Spectrometer2.0/SketchUp_source_file/Spectrometer/Spectrometer_Cover.skp
3Dmodel/Spectrometer2.0/SketchUp_source_file/Spectrometer/Webcam.skp
3Dmodel/Spectrometer2.0/SketchUp_source_file/Spectrometer/Workspace~.skp
3Dmodel/Spectrometer2.0/SketchUp_source_file/Spectrometer/Workspace~~.skp
3Dmodel/Spectrometer2.0/SketchUp_source_file/Spectrometer/assemble.skp
3Dmodel/Spectrometer2.0/SketchUp_source_file/Spectrometer/assemble~.skp
3Dmodel/Spectrometer2.0/SketchUp_source_file/TestingModuleGroup_2.skp
3Dmodel/Spectrometer2.0/SketchUp_source_file/TestingModuleGroup_2~.skp
3Dmodel/Spectrometer2.0/SketchUp_source_file/Testing_Module_1/1.2.1.skp
3Dmodel/Spectrometer2.0/SketchUp_source_file/Testing_Module_1/Module.1.1.skp
3Dmodel/Spectrometer2.0/SketchUp_source_file/Testing_Module_1/Module.1.1~.skp
3Dmodel/Spectrometer2.0/SketchUp_source_file/Testing_Module_1/Module.1.2.skp
3Dmodel/Spectrometer2.0/SketchUp_source_file/Testing_Module_1/Module.1.2~.skp
3Dmodel/Spectrometer2.0/SketchUp_source_file/Testing_Module_1/Module.1.3.skp
3Dmodel/Spectrometer2.0/SketchUp_source_file/Testing_Module_1/Module.1.3~.skp
3Dmodel/Spectrometer2.0/SketchUp_source_file/Testing_Module_1/Testing_Module_1.skp
3Dmodel/Spectrometer2.0/SketchUp_source_file/Testing_Module_1/Testing_Module_1_Grooup.skp
3Dmodel/Spectrometer2.0/SketchUp_source_file/Testing_Module_1/Testing_Module_1_Grooup~.skp
3Dmodel/Spectrometer2.0/SketchUp_source_file/Testing_Module_1/Testing_Module_1~.skp
3Dmodel/Spectrometer2.0/SketchUp_source_file/Testing_Module_2.skp
3Dmodel/Spectrometer2.0/SketchUp_source_file/Testing_Module_2_Group.skp
3Dmodel/Spectrometer2.0/SketchUp_source_file/Testing_Module_2_I.skp
3Dmodel/Spectrometer2.0/SketchUp_source_file/Testing_Module_2_I~.skp
3Dmodel/Spectrometer2.0/SketchUp_source_file/Testing_Module_2~.skp
3Dmodel/Spectrometer2.0/SketchUp_source_file/Workspace.skp
3Dmodel/Spectrometer2.0/SketchUp_source_file/Workspace~.skp
3Dmodel/Spectrometer2.0/SketchUp_source_file/stand.skp
