ymguo-phy/Lab_IV_Spectrometer/Circuit/Windows 10 printed document-1.pdf

0

1

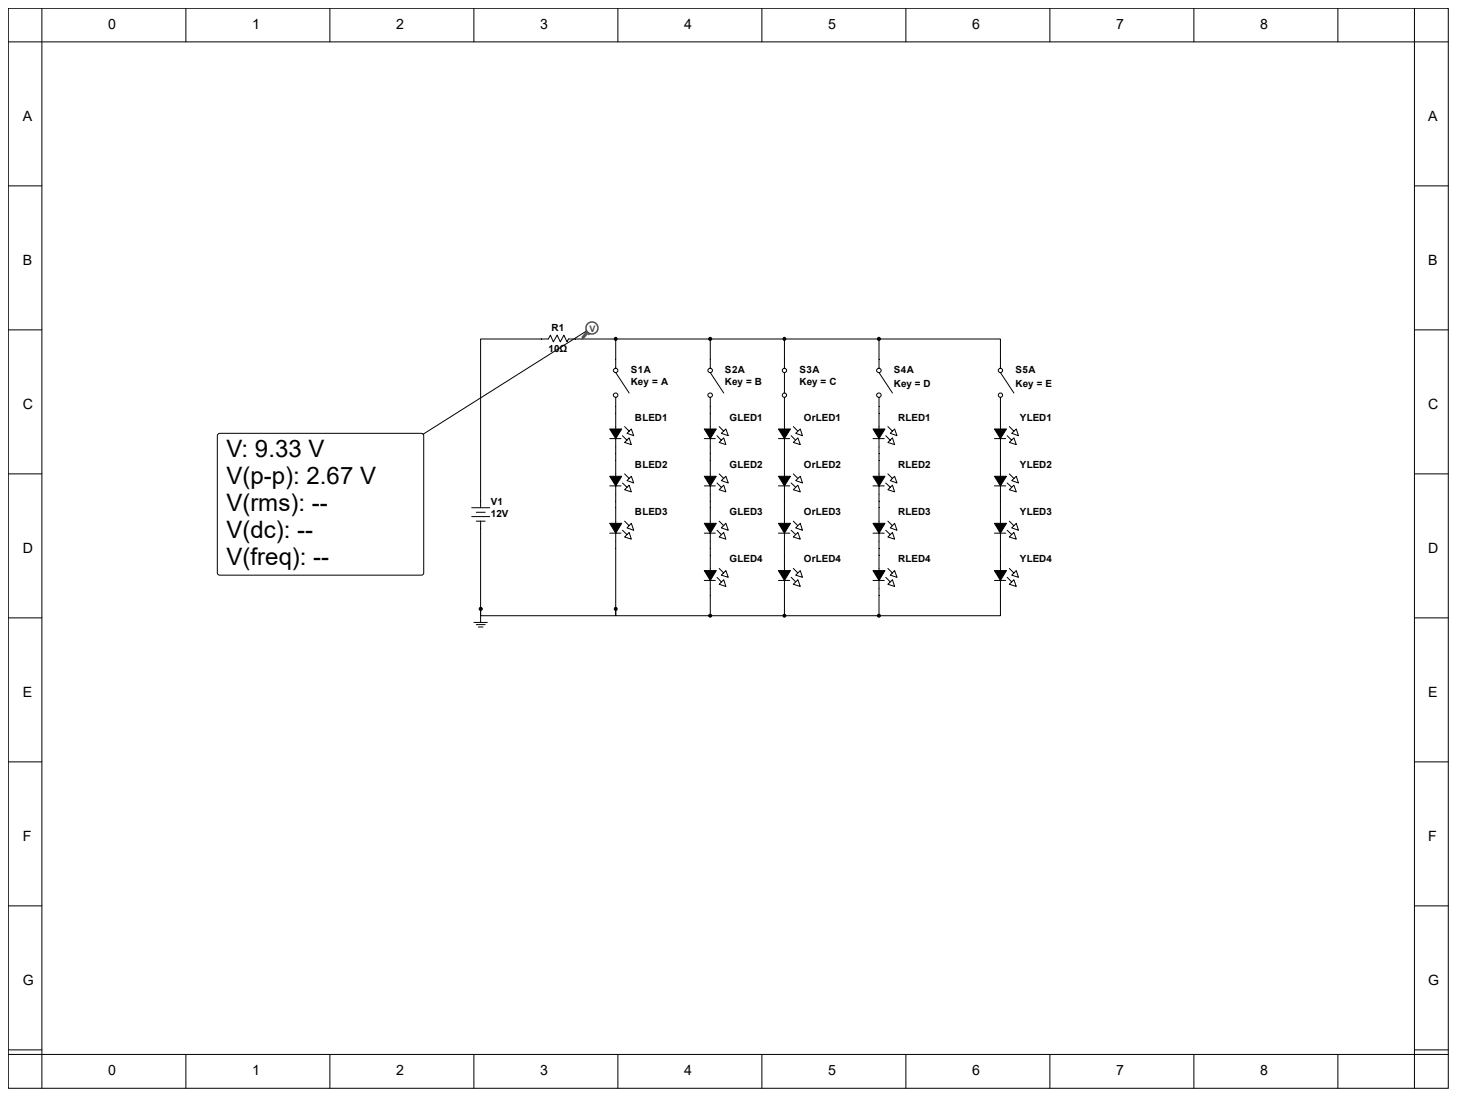
[picture p328: page 1]
ΒLED1; GLED1; OrLED1; RLED1; YLED2; ΒLED2; ΒLED3; GLED2; GLED3; GLED4; S1A Key = A; S2A Key = B; S3A Key = C; OrLED2; OrLED3; OrLED4; RLED2; RLED3; RLED4; YLED3; YLED4; YLED1; S4A Key = D; S5A Key = E; V: 9.33 V V(p-p): 2.67 V V(rms): -- V(dc): -- V(freq): --
