ymguo-phy/Lab_IV_Spectrometer/(list of files, drawings)

Other design files:
Circuit/Design1.ms14
