ymguo-phy/Lab_IV_Spectrometer/(commit log)

2022-04-26 Add tons of things
    Start!
    [Budget.xlsx, Camera_Dock.skp, Design1.ms14, Disc_Dock.skp, Milestone.xlsx, Spectrometer.skp, Spectrometer_Body.skp, Spectrometer_Cover.skp]
2022-04-26 add printable .stl file
    [Camera_Dock.skp, Camera_Dock.stl, Disc_Dock.skp, Disc_Dock.stl, Spectrometer.skp, Spectrometer_Body.skp, Spectrometer_Body.stl, Spectrometer_Cover.skp]
2022-06-27 lots update
    [1.0_底座三脚架连接_A.stl, 1.0_底座三脚架连接_A_2.stl, 1.2.1.skp, 2.1_B.stl, 2.1_B_2.stl, 2.2_B.stl, 2.2_B_2.stl, 2.3_B.stl]
2022-06-30 add budget control
    [Budget.xlsx, Exp_1_2.xlsx, Exp_2的副本.xlsx]
